arthur-cordier/Conductivity_sensor_DIY/Sensor_Template/Core/Inc/main.h

#define LED_RED_Pin GPIO_PIN_5
#define LED_RED_GPIO_Port GPIOE
#define LED_GREEN_Pin GPIO_PIN_6
#define LED_GREEN_GPIO_Port GPIOE
#define BUTTON_Pin GPIO_PIN_13
#define BUTTON_GPIO_Port GPIOC
#define BUTTON_EXTI_IRQn EXTI13_IRQn
#define GPIO_EXT_8_Pin GPIO_PIN_0
#define GPIO_EXT_8_GPIO_Port GPIOC
#define GPIO_EXT_5_Pin GPIO_PIN_8
#define GPIO_EXT_5_GPIO_Port GPIOA
#define USART1_RX_Pin GPIO_PIN_10
#define USART1_RX_GPIO_Port GPIOA
#define SDCARD_DETECT_Pin GPIO_PIN_0
#define SDCARD_DETECT_GPIO_Port GPIOD
#define GPIO_EXT_7_Pin GPIO_PIN_5
#define GPIO_EXT_7_GPIO_Port GPIOD
#define GPIO_EXT_6_Pin GPIO_PIN_6
#define GPIO_EXT_6_GPIO_Port GPIOD
#define I2C_EXT_SCL_Pin GPIO_PIN_6
#define I2C_EXT_SCL_GPIO_Port GPIOB
#define I2C_EXT_SDA_Pin GPIO_PIN_7
#define I2C_EXT_SDA_GPIO_Port GPIOB
#define GPIO_EXT_4_Pin GPIO_PIN_3
#define GPIO_EXT_4_GPIO_Port GPIOH
#define GPIO_EXT_3_Pin GPIO_PIN_8
#define GPIO_EXT_3_GPIO_Port GPIOB
#define GPIO_EXT_2_Pin GPIO_PIN_9
#define GPIO_EXT_2_GPIO_Port GPIOB
#define GPIO_EXT_1_Pin GPIO_PIN_0
#define GPIO_EXT_1_GPIO_Port GPIOE
#define FIST_OF_THE_YEAR_TS 1672531200
