arthur-cordier/Conductivity_sensor_DIY/Sensor_Template/Core/Src/adc.c

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
/* Includes ------------------------------------------------------------------*/
#include "adc.h"

/* USER CODE BEGIN 0 */
#include "tim.h"
#include <stdio.h>
#define V_REF 3.3f
volatile uint8_t fft_ready = 0;
arm_rfft_fast_instance_f32 fft_instance;

uint16_t adc4_raw_samples[FFT_SAMPLE_SIZE * 2];     // Intercalé IN3/IN4
float32_t adc4_in_f32[FFT_SAMPLE_SIZE];     // Entrée capteur
float32_t adc4_out_f32[FFT_SAMPLE_SIZE];    // Sortie capteur
float32_t fft_output_in[FFT_SAMPLE_SIZE];
float32_t fft_output_out[FFT_SAMPLE_SIZE];
float32_t fft_amplitude_in[FFT_SAMPLE_SIZE / 2];
float32_t fft_amplitude_out[FFT_SAMPLE_SIZE / 2];
/* USER CODE END 0 */

ADC_HandleTypeDef hadc4;
DMA_NodeTypeDef Node_GPDMA1_Channel0;
DMA_QListTypeDef List_GPDMA1_Channel0;
DMA_HandleTypeDef handle_GPDMA1_Channel0;

/* ADC4 init function */
void MX_ADC4_Init(void)
{

  ADC_ChannelConfTypeDef sConfig = {0};

  /** Common config
  */
  hadc4.Instance = ADC4;
  hadc4.Init.ClockPrescaler = ADC_CLOCK_ASYNC_DIV1;
  hadc4.Init.Resolution = ADC_RESOLUTION_12B;
  hadc4.Init.DataAlign = ADC_DATAALIGN_RIGHT;
  hadc4.Init.ScanConvMode = ADC4_SCAN_ENABLE;
  hadc4.Init.EOCSelection = ADC_EOC_SEQ_CONV;
  hadc4.Init.LowPowerAutoPowerOff = ADC_LOW_POWER_NONE;
  hadc4.Init.LowPowerAutoWait = DISABLE;
  hadc4.Init.ContinuousConvMode = DISABLE;
  hadc4.Init.NbrOfConversion = 2;
  hadc4.Init.DiscontinuousConvMode = DISABLE;
  hadc4.Init.ExternalTrigConv = ADC4_EXTERNALTRIG_T2_TRGO;
  hadc4.Init.ExternalTrigConvEdge = ADC_EXTERNALTRIGCONVEDGE_RISING;
  hadc4.Init.DMAContinuousRequests = ENABLE;
  hadc4.Init.TriggerFrequencyMode = ADC_TRIGGER_FREQ_HIGH;
  hadc4.Init.Overrun = ADC_OVR_DATA_PRESERVED;
  hadc4.Init.SamplingTimeCommon1 = ADC4_SAMPLETIME_79CYCLES_5;
  hadc4.Init.SamplingTimeCommon2 = ADC4_SAMPLETIME_79CYCLES_5;
  hadc4.Init.OversamplingMode = DISABLE;
  if (HAL_ADC_Init(&hadc4) != HAL_OK)
  {
    Error_Handler();
  }

  /** Configure Regular Channel
  */
  sConfig.Channel = ADC_CHANNEL_4;
  sConfig.Rank = ADC4_REGULAR_RANK_1;
  sConfig.SamplingTime = ADC4_SAMPLINGTIME_COMMON_1;
  sConfig.OffsetNumber = ADC_OFFSET_NONE;
  sConfig.Offset = 0;
  if (HAL_ADC_ConfigChannel(&hadc4, &sConfig) != HAL_OK)
  {
    Error_Handler();
  }

  /** Configure Regular Channel
  */
  sConfig.Channel = ADC_CHANNEL_10;
  sConfig.Rank = ADC4_REGULAR_RANK_2;
  if (HAL_ADC_ConfigChannel(&hadc4, &sConfig) != HAL_OK)
  {
    Error_Handler();
  }
}

void HAL_ADC_MspInit(ADC_HandleTypeDef* adcHandle)
{

  GPIO_InitTypeDef GPIO_InitStruct = {0};
  DMA_NodeConfTypeDef NodeConfig= {0};
  RCC_PeriphCLKInitTypeDef PeriphClkInit = {0};
  if(adcHandle->Instance==ADC4)
  {
  /** Initializes the peripherals clock
  */
    PeriphClkInit.PeriphClockSelection = RCC_PERIPHCLK_ADCDAC;
    PeriphClkInit.AdcDacClockSelection = RCC_ADCDACCLKSOURCE_HSI;
    if (HAL_RCCEx_PeriphCLKConfig(&PeriphClkInit) != HAL_OK)
    {
      Error_Handler();
    }

    /* ADC4 clock enable */
    __HAL_RCC_ADC4_CLK_ENABLE();

    __HAL_RCC_GPIOC_CLK_ENABLE();
    __HAL_RCC_GPIOA_CLK_ENABLE();
    /**ADC4 GPIO Configuration
    PC3     ------> ADC4_IN4
    PA5     ------> ADC4_IN10
    */
    GPIO_InitStruct.Pin = GPIO_PIN_3;
    GPIO_InitStruct.Mode = GPIO_MODE_ANALOG;
    GPIO_InitStruct.Pull = GPIO_NOPULL;
    HAL_GPIO_Init(GPIOC, &GPIO_InitStruct);

    GPIO_InitStruct.Pin = GPIO_PIN_5;
    GPIO_InitStruct.Mode = GPIO_MODE_ANALOG;
    GPIO_InitStruct.Pull = GPIO_NOPULL;
    HAL_GPIO_Init(GPIOA, &GPIO_InitStruct);

    /* ADC4 DMA Init */
    /* GPDMA1_REQUEST_ADC4 Init */
    NodeConfig.NodeType = DMA_GPDMA_LINEAR_NODE;
    NodeConfig.Init.Request = GPDMA1_REQUEST_ADC4;
    NodeConfig.Init.BlkHWRequest = DMA_BREQ_SINGLE_BURST;
    NodeConfig.Init.Direction = DMA_PERIPH_TO_MEMORY;
    NodeConfig.Init.SrcInc = DMA_SINC_FIXED;
    NodeConfig.Init.DestInc = DMA_DINC_INCREMENTED;
    NodeConfig.Init.SrcDataWidth = DMA_SRC_DATAWIDTH_HALFWORD;
    NodeConfig.Init.DestDataWidth = DMA_DEST_DATAWIDTH_HALFWORD;
    NodeConfig.Init.SrcBurstLength = 1;
    NodeConfig.Init.DestBurstLength = 1;
    NodeConfig.Init.TransferAllocatedPort = DMA_SRC_ALLOCATED_PORT0|DMA_DEST_ALLOCATED_PORT0;
    NodeConfig.Init.TransferEventMode = DMA_TCEM_BLOCK_TRANSFER;
    NodeConfig.Init.Mode = DMA_NORMAL;
    NodeConfig.TriggerConfig.TriggerPolarity = DMA_TRIG_POLARITY_MASKED;
    NodeConfig.DataHandlingConfig.DataExchange = DMA_EXCHANGE_NONE;
    NodeConfig.DataHandlingConfig.DataAlignment = DMA_DATA_RIGHTALIGN_ZEROPADDED;
    if (HAL_DMAEx_List_BuildNode(&NodeConfig, &Node_GPDMA1_Channel0) != HAL_OK)
    {
      Error_Handler();
    }

    if (HAL_DMAEx_List_InsertNode(&List_GPDMA1_Channel0, NULL, &Node_GPDMA1_Channel0) != HAL_OK)
    {
      Error_Handler();
    }

    if (HAL_DMAEx_List_SetCircularMode(&List_GPDMA1_Channel0) != HAL_OK)
    {
      Error_Handler();
    }

    handle_GPDMA1_Channel0.Instance = GPDMA1_Channel0;
    handle_GPDMA1_Channel0.InitLinkedList.Priority = DMA_LOW_PRIORITY_HIGH_WEIGHT;
    handle_GPDMA1_Channel0.InitLinkedList.LinkStepMode = DMA_LSM_FULL_EXECUTION;
    handle_GPDMA1_Channel0.InitLinkedList.LinkAllocatedPort = DMA_LINK_ALLOCATED_PORT0;
    handle_GPDMA1_Channel0.InitLinkedList.TransferEventMode = DMA_TCEM_BLOCK_TRANSFER;
    handle_GPDMA1_Channel0.InitLinkedList.LinkedListMode = DMA_LINKEDLIST_CIRCULAR;
    if (HAL_DMAEx_List_Init(&handle_GPDMA1_Channel0) != HAL_OK)
    {
      Error_Handler();
    }

    if (HAL_DMAEx_List_LinkQ(&handle_GPDMA1_Channel0, &List_GPDMA1_Channel0) != HAL_OK)
    {
      Error_Handler();
    }

    __HAL_LINKDMA(adcHandle, DMA_Handle, handle_GPDMA1_Channel0);

    if (HAL_DMA_ConfigChannelAttributes(&handle_GPDMA1_Channel0, DMA_CHANNEL_NPRIV) != HAL_OK)
    {
      Error_Handler();
    }

    /* ADC4 interrupt Init */
    HAL_NVIC_SetPriority(ADC4_IRQn, 0, 0);
    HAL_NVIC_EnableIRQ(ADC4_IRQn);
  }
}

void HAL_ADC_MspDeInit(ADC_HandleTypeDef* adcHandle)
{

  if(adcHandle->Instance==ADC4)
  {
    /* Peripheral clock disable */
    __HAL_RCC_ADC4_CLK_DISABLE();

    /**ADC4 GPIO Configuration
    PC3     ------> ADC4_IN4
    PA5     ------> ADC4_IN10
    */
    HAL_GPIO_DeInit(GPIOC, GPIO_PIN_3);

    HAL_GPIO_DeInit(GPIOA, GPIO_PIN_5);

    /* ADC4 DMA DeInit */
    HAL_DMA_DeInit(adcHandle->DMA_Handle);

    /* ADC4 interrupt Deinit */
    HAL_NVIC_DisableIRQ(ADC4_IRQn);
  }
}

/* USER CODE BEGIN 1 */
float ADC4_ReadVoltage(void)
{
    HAL_ADC_Stop(&hadc4); // Sécurisation du contexte
    HAL_ADCEx_Calibration_Start(&hadc4, ADC_CALIB_OFFSET, ADC_SINGLE_ENDED);
    HAL_ADC_Start(&hadc4);
    HAL_ADC_PollForConversion(&hadc4, HAL_MAX_DELAY);
    uint16_t raw = HAL_ADC_GetValue(&hadc4);
    HAL_ADC_Stop(&hadc4);

    float voltage = (raw * V_REF) / 4096.0f; // 12-bit resolution
    printf("ADC4 brut : %u, Tension : %.2f V\r\n", raw, voltage);
    return voltage;
}



void HAL_ADC_ConvCpltCallback(ADC_HandleTypeDef* hadc)
{
    if (hadc->Instance == ADC4)
    {

        fft_ready = 1;
    }
}


void ADC_Start(void)
{
	  HAL_ADCEx_Calibration_Start(&hadc4, ADC_CALIB_OFFSET, ADC_SINGLE_ENDED);
	  HAL_ADC_Start_DMA(&hadc4, (uint32_t*)adc4_raw_samples, FFT_SAMPLE_SIZE * 2);
	  HAL_TIM_Base_Start(&htim2);
	  HAL_TIM_GenerateEvent(&htim2, TIM_EVENTSOURCE_UPDATE); // ← cette ligne débloque le TRGO
}
/* USER CODE END 1 */
