arthur-cordier/Conductivity_sensor_DIY/Sensor_Template/Core/Src/dac.c

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
/* Includes ------------------------------------------------------------------*/
#include "dac.h"

/* USER CODE BEGIN 0 */
#include "math.h"
#include "tim.h"
#include "stm32u5xx_hal.h"
#include "stm32u5xx_hal_dma.h"
#include <stdio.h>

uint16_t sine_wave[DAC_BUFFER_SIZE];
/* USER CODE END 0 */

DAC_HandleTypeDef hdac1;

/* DAC1 init function */
void MX_DAC1_Init(void)
{

  DAC_ChannelConfTypeDef sConfig = {0};
  DAC_AutonomousModeConfTypeDef sAutonomousMode = {0};

  /** DAC Initialization
  */
  hdac1.Instance = DAC1;
  if (HAL_DAC_Init(&hdac1) != HAL_OK)
  {
    Error_Handler();
  }

  /** DAC channel OUT1 config
  */
  sConfig.DAC_HighFrequency = DAC_HIGH_FREQUENCY_INTERFACE_MODE_DISABLE;
  sConfig.DAC_DMADoubleDataMode = DISABLE;
  sConfig.DAC_SignedFormat = DISABLE;
  sConfig.DAC_SampleAndHold = DAC_SAMPLEANDHOLD_DISABLE;
  sConfig.DAC_Trigger = DAC_TRIGGER_NONE;
  sConfig.DAC_OutputBuffer = DAC_OUTPUTBUFFER_ENABLE;
  sConfig.DAC_ConnectOnChipPeripheral = DAC_CHIPCONNECT_EXTERNAL;
  sConfig.DAC_UserTrimming = DAC_TRIMMING_FACTORY;
  if (HAL_DAC_ConfigChannel(&hdac1, &sConfig, DAC_CHANNEL_1) != HAL_OK)
  {
    Error_Handler();
  }

  /** Configure Autonomous Mode
  */
  sAutonomousMode.AutonomousModeState = DAC_AUTONOMOUS_MODE_DISABLE;
  if (HAL_DACEx_SetConfigAutonomousMode(&hdac1, &sAutonomousMode) != HAL_OK)
  {
    Error_Handler();
  }
}

void HAL_DAC_MspInit(DAC_HandleTypeDef* dacHandle)
{

  GPIO_InitTypeDef GPIO_InitStruct = {0};
  RCC_PeriphCLKInitTypeDef PeriphClkInit = {0};
  if(dacHandle->Instance==DAC1)
  {
  /** Initializes the peripherals clock
  */
    PeriphClkInit.PeriphClockSelection = RCC_PERIPHCLK_ADCDAC|RCC_PERIPHCLK_DAC1;
    PeriphClkInit.AdcDacClockSelection = RCC_ADCDACCLKSOURCE_HSI;
    PeriphClkInit.Dac1ClockSelection = RCC_DAC1CLKSOURCE_LSI;
    if (HAL_RCCEx_PeriphCLKConfig(&PeriphClkInit) != HAL_OK)
    {
      Error_Handler();
    }

    /* DAC1 clock enable */
    __HAL_RCC_DAC1_CLK_ENABLE();

    __HAL_RCC_GPIOA_CLK_ENABLE();
    /**DAC1 GPIO Configuration
    PA4     ------> DAC1_OUT1
    */
    GPIO_InitStruct.Pin = GPIO_PIN_4;
    GPIO_InitStruct.Mode = GPIO_MODE_ANALOG;
    GPIO_InitStruct.Pull = GPIO_NOPULL;
    HAL_GPIO_Init(GPIOA, &GPIO_InitStruct);

  }
}

void HAL_DAC_MspDeInit(DAC_HandleTypeDef* dacHandle)
{

  if(dacHandle->Instance==DAC1)
  {
    /* Peripheral clock disable */
    __HAL_RCC_DAC1_CLK_DISABLE();

    /**DAC1 GPIO Configuration
    PA4     ------> DAC1_OUT1
    */
    HAL_GPIO_DeInit(GPIOA, GPIO_PIN_4);

  }
}

/* USER CODE BEGIN 1 */
void GenerateSineTable(void)
{
    const float amplitude_v = 0.25f;  // 0.5V crête à crête
    const float offset_v = 0.30f;     // centré sur 0.3V pour evité l'écrêtage en bas de la sinusoïde
    const float vref = 3.3f;
    const float dac_max = 4095.0f;

    for (int i = 0; i < DAC_BUFFER_SIZE; i++) {
        float angle = 2.0f * M_PI * i / DAC_BUFFER_SIZE;
        float val = sinf(angle) * amplitude_v + offset_v;
        sine_wave[i] = (uint16_t)((val / vref) * dac_max);
    }
}


void DAC_Start(void)
{
	  HAL_DAC_Start(&hdac1, DAC_CHANNEL_1);
	  GenerateSineTable();
	  HAL_TIM_Base_Start(&htim15);
}


//extern volatile uint16_t sin_index;
//
//void HAL_TIM_PeriodElapsedCallback(TIM_HandleTypeDef *htim)
//{
//    if (htim->Instance == TIM15)
//    {
//        HAL_DAC_SetValue(&hdac1, DAC_CHANNEL_1, DAC_ALIGN_12B_R, sine_wave[sin_index]);
//        sin_index = (sin_index + 1) % DAC_BUFFER_SIZE;
//    }
//}
/* USER CODE END 1 */
