arthur-cordier/Conductivity_sensor_DIY/(notices)

Notices in the files:
Sensor_Template/Core/Inc/adc.h:
Copyright (c) 2025 STMicroelectronics.
All rights reserved.
This software is licensed under terms that can be found in the LICENSE file
Sensor_Template/Core/Inc/main.h:
Copyright (c) 2024 STMicroelectronics.
